reksastacode/ESP32-AutoFishFeeder/hardware/wiring_pcb_lubang.png

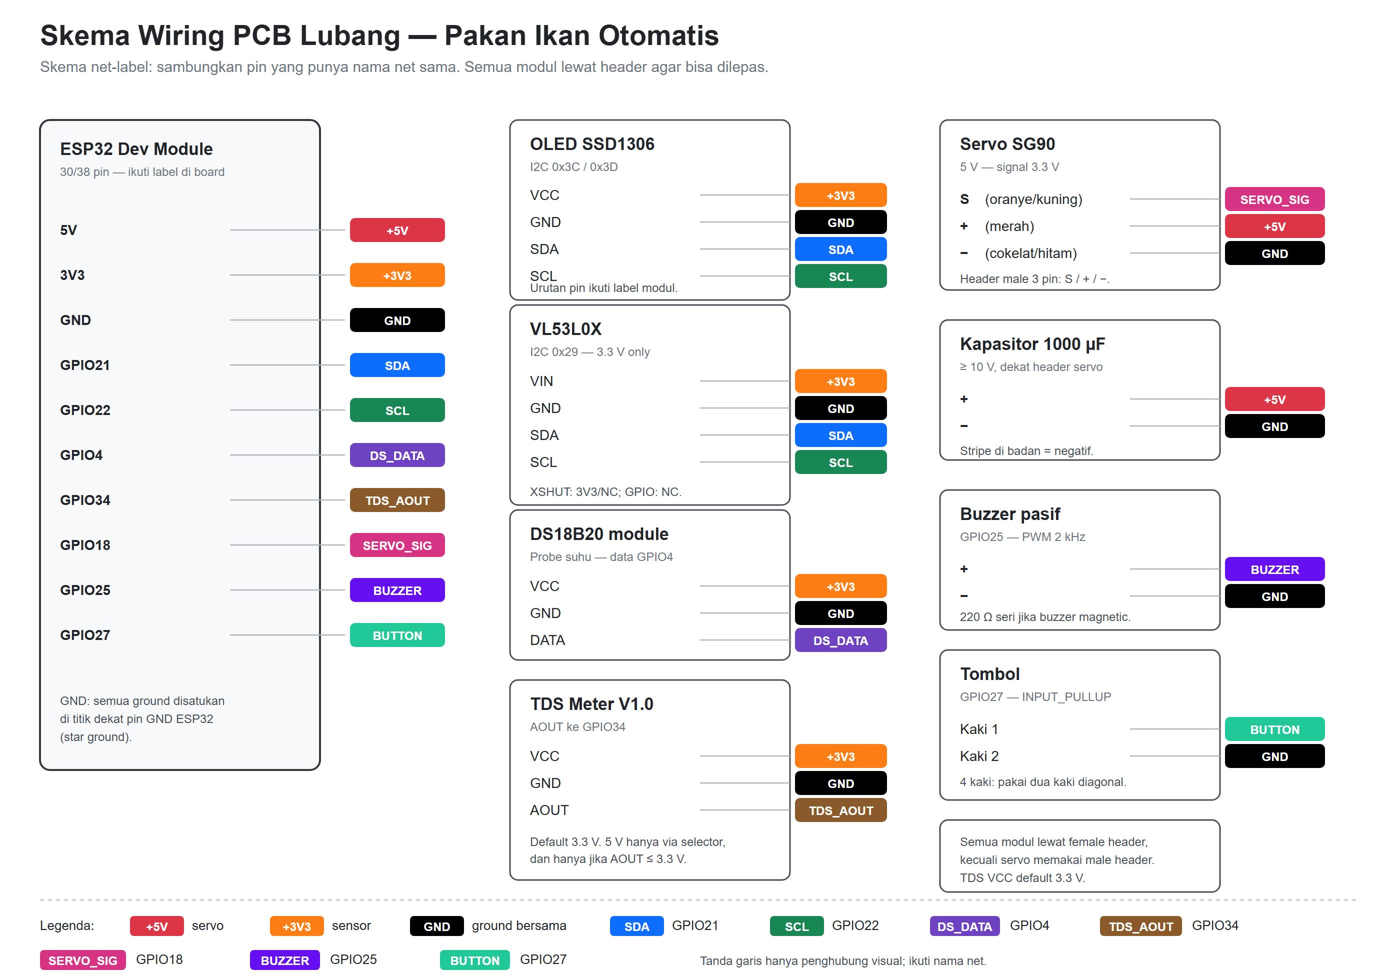
hardware/wiring_pcb_lubang.png
